Kirill-Kasparov/Smart-LED-lamp-Arduino/Распиновка.JPG

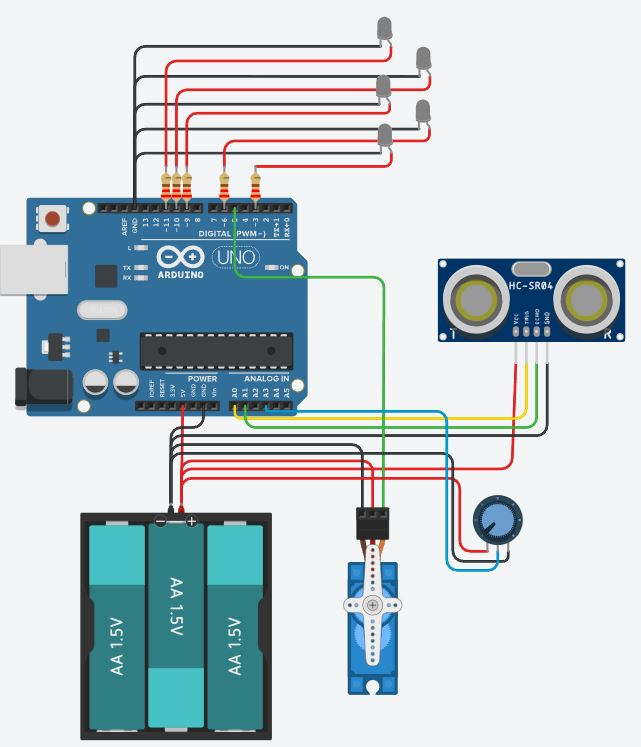
Распиновка.JPG
