Kirill-Kasparov/Smart-LED-lamp-Arduino/Схема.pdf

A

1 | 2 | 3 | 4 | 5 | 6

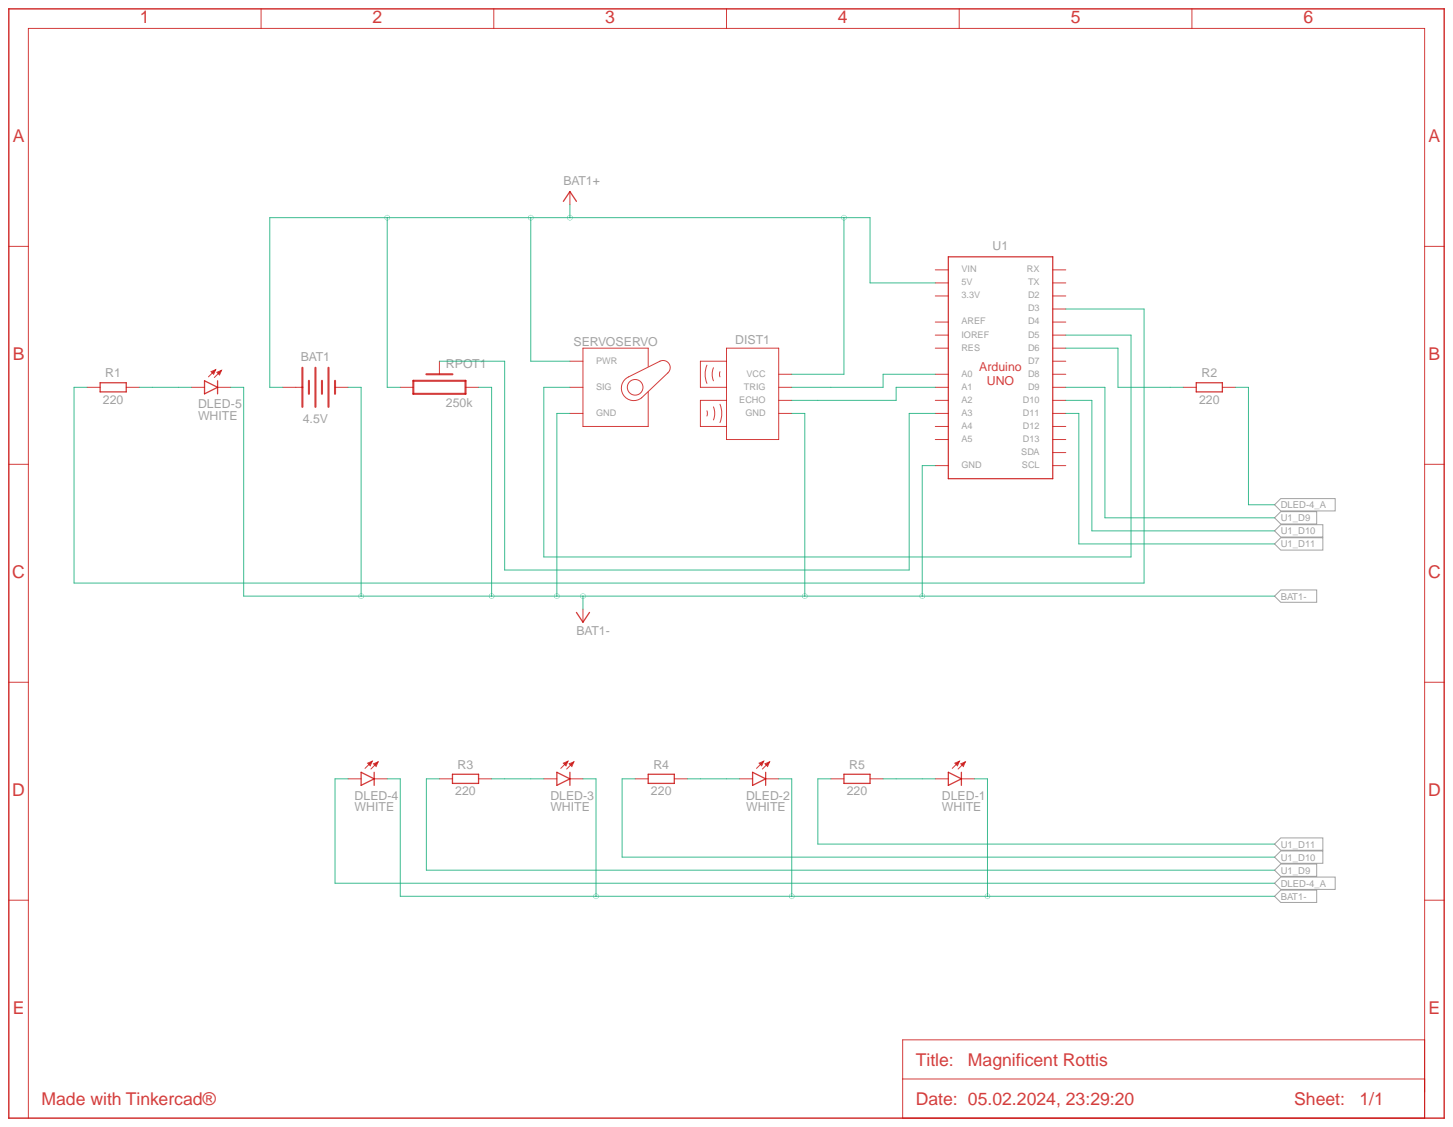
[picture p2: page 1]
