Kirill-Kasparov/Smart-LED-lamp-Arduino/(commit log)

2024-02-10 Update README.md
    Обновлено поведение сервомотора
2024-02-10 Update smartLED-forGh.ino
    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
